odevincenti/Biosc/README.md

# Biosc

Desarrollo de un dispositivo de visualización y generación de señales con fines didácticos.
