odevincenti/Biosc/Diseño/Etapa de Entrada/Bioscope-Input-01/Bioscope-Input-01-SCH.pdf

# Bioscope Input Stage

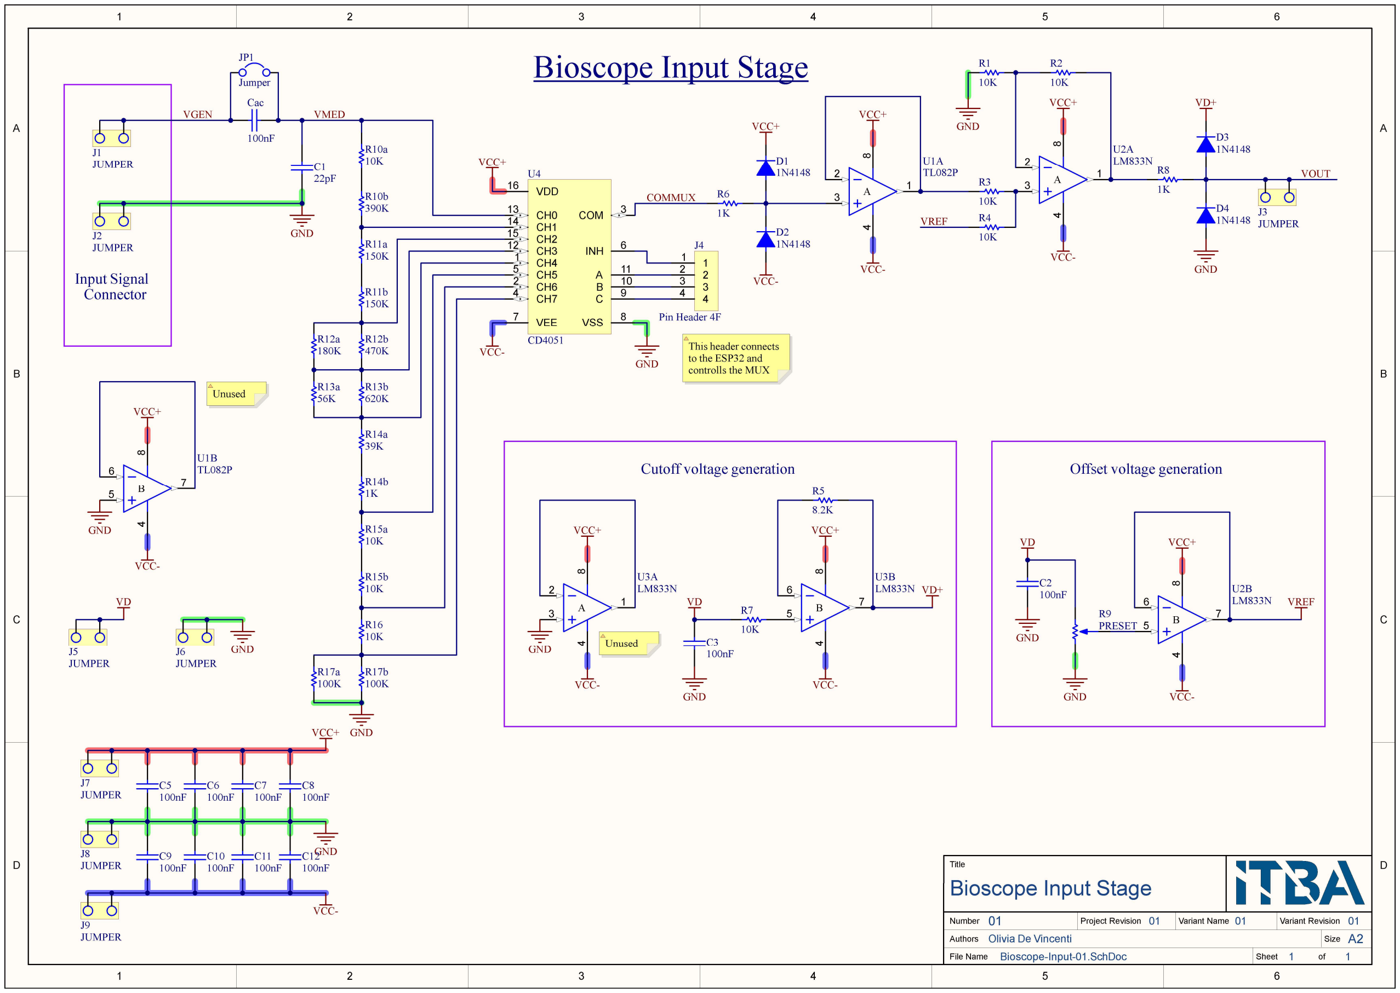
[picture p1: page 1]

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
# Bioscope Input Stage

A2
Bioscope-Input-01.SchDoc | 1

Title

Size

File Name | Sheet | of
Project Revision 01 | 01 | 01 Variant Revision
Olivia De Vincenti

Number 01

1

Authors

Variant Name

2

3

### 1 A⁸ 4

U2A
LM833N

5

6

### 7 B⁸ 4

U2B
LM833N

2

3

### 1 A⁸ 4

U3A
LM833N

5

6

### 7 B⁸ 4

U3B
LM833N

J1
JUMPER

J2
JUMPER

VGEN

Cac

100nF

JP1

Jumper

C1
22pF

GND

VMED

R10a
10K

R11a
150K

R12b
470K

R13b
620K

R14a
39K

R15a
10K

R16
10K

R17b
100K

GND

COMMUX

GND

INH 6

C

9

CH0 13
CH1 14
CH2 15
CH3 12
CH4 1
CH5 5
CH6 2
CH7 4

VDD 16

VEE 7 | VSS | 8
COM | 3

A

11
B

10

U4

CD4051

VCC+

VCC-

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
Pin Header 4F

D1
1N4148

D2
1N4148

VCC+

VCC-

2

3

### 1 A⁸ 4

U1A
TL082P

5

6

### 7 B⁸ 4

U1B
TL082P

VCC+

VCC-

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
VREF

VCC+

VCC-

VOUT

J7
JUMPER

J8
JUMPER

GND

J9
JUMPER

VCC+

VCC-

J3
JUMPER

VCC+

VCC-

VCC+

VCC-

VD+
VD

R5
8.2K

R7
10K

VCC+

VCC-

VREF

VD

GND

C2
100nF

C5
100nF

C6
100nF

C7
100nF

C9
100nF

C10
100nF

C11
100nF

C8
100nF

C12
100nF

GND C3
100nF

GND

VCC+

VCC-

GND

J5
JUMPER

VD

J6
JUMPER

GND

## Input Signal Connector

Cutoff voltage generation | Offset voltage generation

R10b
390K

R11b
150K

R12a
180K

R13a
56K

R14b
1K

R15b
10K

R17a
100K

R6
1K

D3
1N4148

D4
1N4148

VD+

R8
1K

GND

GND

R9
PRESET

This header connects
to the ESP32 and
controlls the MUX

Unused

Unused
