odevincenti/Biosc/Documentación/Componentes.md

# Componentes

- Microprocesador: [ESP-WROOM-32](https://www.espressif.com/sites/default/files/documentation/esp32-wroom-32_datasheet_en.pdf)
- Placa de desarrollo: [NODEMCU ESP-32S](https://docs.ai-thinker.com/_media/esp32/docs/nodemcu-32s_product_specification.pdf) V1.1 (38 pines)
- ADC: [ADS1115](https://www.ti.com/lit/ds/symlink/ads1115.pdf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) ADC 16 bits 860sps 2 canales
- Generador de señal: [AD9833](https://www.analog.com/media/en/technical-documentation/data-sheets/ad9833.pdf)
- Convertidor aislado: [B1212S-2WR2](https://www.micros.com.pl/mediaserver/info-dc%20a0505s-2wr2.pdf) Convertidor aislado 12V-12V no regulado para usar como fuente partida ±12V.
- Convertidor switching: [CN6009](https://www.pollin.de/productdownloads/D351434D.PDF) Regulador Step Up Vout 0V - 60V
- Fuente de alimentación: [PWR-5V2A](https://www.todomicro.com.ar/FUENTES-DE-ALIMENTACION/666-fuente-de-alimentacion-5v-2a.html) Fuente 5V 2A, entrada de la pared.
