odevincenti/Biosc/Diseño/Etapa de Entrada/Bioscope-Input-01/Bioscope-Input-01-BOM.xlsx

Comment | Description | Designator | Footprint | LibRef | Quantity
22pF |  | C1 | CAP100 | CAP | 1
100nF |  | C2, C5, C6, C7, C8, C9, C11, C12, Cac | CAP100 | CAP | 9
100nF |  | C3, C10 | CAP200 | CAP | 2
1N4148 |  | D1, D2, D3, D4 | DO41 | DIODO | 4
JUMPER |  | J1, J2, J3, J5, J6, J7, J8, J9 | JUMPER2 | JUMPER | 8
Pin Header 4F | Pin Header, Female, 4 positions | J4 | PINHEADER-4F | PINHEADER-4F | 1
Jumper | 2.54mm 2 pin header and jumper | JP1 | JUMPER-HEADER | Jumper Header | 1
10K |  | R1, R2, R3, R4, R7, R10a, R15a, R15b, R16 | RES400 | RES | 9
8.2K |  | R5 | RES400 | RES | 1
1K |  | R6, R8, R14b | RES400 | RES | 3
PRESET |  | R9 | PRESET V | PRESET | 1
390K |  | R10b | RES400 | RES | 1
150K |  | R11a, R11b | RES400 | RES | 2
180K |  | R12a | RES400 | RES | 1
470K |  | R12b | RES400 | RES | 1
56K |  | R13a | RES400 | RES | 1
620K |  | R13b | RES400 | RES | 1
39K |  | R14a | RES400 | RES | 1
100K |  | R17a, R17b | RES400 | RES | 2
TL082P | JFET-Input Operational Amplifier | U1 | P008 | TL082P | 1
LM833N | Low-Noise Dual Operational Amplifier | U2, U3 | DIP8 | LM833N | 2
CD4051 | Single 8-Channel Analog Multiplexer or Demultiplexer | U4 | SOIC16 | CD4051BF | 1
