odevincenti/Biosc/Documentación/Especificaciones de Diseño.xlsx

Sheet: Especificaciones de medición
Especificaciones de diseño - Etapa de medición
ID | Descripción | Origen
INT-MED-01 | El dispositivo deberá contar con un módulo ADC | REQ-01
INT-MED-02 | El dispositivo deberá contar con circuito de atenuación/amplificación para medir en el rango entre ±100mV y ±12V | REQ-02
INT-MED-03 | El dispositivo deberá poder ajustar el grado de atenuación/amplificación tal que la resolución de la señal sea óptima | REQ-02
INT-MED-04 | El módulo ADC deberá contar con una frecuencia de sampleo mayor a 200KHz | REQ-03
INT-MED-05 | El circuito de medición deberá tener un ancho de banda mayor a 100KHz | REQ-03
INT-MED-06 | El dispositivo deberá contar con 4 circuitos de medición | REQ-04
INT-MED-07 | La etapa de entrada del circuito de medición deberá contar con un limitador de tensión | REQ-05
INT-MED-08 | El circuito de medición deberá contar con una alta impedancia de entrada | REQ-05

Sheet: Especificaciones de generación
Especificaciones de diseño - Etapa de generación
ID | Descripción | Origen
INT-GEN-01 | El dispositivo deberá contar con una fuente partida de ±12V | REQ-12
INT-GEN-02 | El dispositivo deberá contar con un generador de señales senoidales, cuadradas y triangulares con frecuencias de hasta 1MHz | REQ-13
INT-GEN-03 | El dispositivo deberá contar con circuito de atenuación/amplificación para generar señales de hasta 10Vpp | REQ-13
INT-GEN-04 | El circuito de medición deberá tener un ancho de banda mayor a 100KHz | REQ-13
INT-GEN-05 | El circuito deberá contar con un regulador lineal para generar tensiones continuas de offset entre ±5V | REQ-14
INT-GEN-06 | El circuito deberá contar con una conexión interna al canal 4, que se habilite para medir la señal generada | REQ-15
INT-GEN-07 | El circuito de generación deberá contar con un fusible y un varistor en la salida | REQ-05

Sheet: Especificaciones de display
Especificaciones de diseño - Interfaz Gráfica de Usuario
ID | Descripción | Origen
INT-DISP-01 | La interfaz gráfica de usuario (GUI) deberá ser una aplicación que corra desde una computadora | REQ-01
INT-DISP-02 | La aplicación deberá ser portable entre sistemas operativos, pudiendo ser compilada en Windows, Mac y Linux | REQ-01
INT-DISP-03 | La GUI deberá poder representar las señales en tiempo real | REQ-01
INT-DISP-04 | La GUI deberá poder superponer las señales de los 4 canales | REQ-04
INT-DISP-05 | La GUI deberá permitir seleccionar qué canales representar | REQ-08
INT-DISP-06 | La GUI deberá contar con un botón Run/Stop para habilitar la representación gráfica de las señales | REQ-06
INT-DISP-07 | La GUI deberá permitir ajustar la escala horizontal de todos los canales representados en una base de tiempo compuesta por décadas múltiples de 1, 2, y 5 | REQ-07
INT-DISP-08 | La GUI deberá permitir ajustar el offset horizontal de todos los canales representados en un valor arbitrario | REQ-07
INT-DISP-09 | La GUI deberá permitir ajustar la escala vertical de cada canal representado por separado, en una base de tiempo compuesta por décadas múltiples de 1, 2, y 5 | REQ-07
INT-DISP-10 | La GUI deberá permitir ajustar el offset vertical de cada canal representadas en un valor arbitrario | REQ-07
INT-DISP-11 | La GUI deberá permitir ajustar la escala vertical de cada canal con la ruedita del mouse, para una mejor experiencia de usuario | REQ-01
INT-DISP-12 | La GUI deberá contar con un sistema de Trigger, que permita configurar el tipo (ascendente, descendente, ambos), el canal de referencia y el nivel de Trigger | REQ-09
INT-DISP-13 | La GUI deberá contar con un botón que setee el modo Single | REQ-10
INT-DISP-14 | La GUI deberá permitir seleccionar entre los modos Roll, Trigger y XY para la representación de las señales | REQ-10
INT-DISP-15 | La GUI deberá permitir exportar una imagen en formato PNG que muestre las señales representadas junto con la escala de cada canal y la base de tiempo | REQ-11
INT-DISP-16 | La GUI deberá permitir exportar los puntos de las señales representadas en formato CSV, con una estructura similar a la de un osciloscopio convencional | REQ-11
INT-DISP-17 | La GUI deberá contar con un botón que habilite la medición de la señal generada en el canal 4 | REQ-15
INT-DISP-18 | La GUI deberá poder funcionar correctamente sin conexión a internet | REQ-18

Sheet: Especificaciones de interfaz
Especificaciones de diseño - Interfaz de datos
ID | Descripción | Origen
INT-COM-01 | La transmisión de datos debe realizarse mediante un cable Micro-USB a USB-A. | REQ-01
INT-COM-02 | La comunicación entre la GUI y el dispositivo deberá ser a través del protocolo UART, con un baud rate de 460800 bits/s | REQ-01
INT-COM-03 | La comunicación entre la GUI y el dispositivo deberá ser codificada con un protocolo de comunicación para reducir el tamaño de la transmisión | REQ-01
INT-COM-04 | La transmisión de los datos de las señales se realizará desde el dispositivo hacia la GUI | REQ-01
INT-COM-05 | El dispositivo deberá transmitir información de los canales seleccionados en paquetes de datos, cada intervalos periódicos | REQ-01
INT-COM-06 | La transmisión de comandos se realizará desde la GUI hacia el dispositivo | REQ-01
INT-COM-07 | Ante un error de lectura se deberá enviar un mensaje de error indicando el tipo de mensaje y el tipo de error | REQ-01
