odevincenti/Biosc/Documentación/Requerimientos de Cliente.xlsx

Requerimientos de Cliente
ID | Descripción | Origen
REQ-01 | El dispositivo deberá poder medir señales eléctricas y representarlas en una interfaz gráfica de usuario (GUI) de computadora intuitiva | Cliente
REQ-02 | El dispositivo deberá poder medir señales con amplitud entre ±100mV y ±12V | Cliente
REQ-03 | El dispositivo deberá poder medir señales con frecuencias hasta 100KHz | Cliente
REQ-04 | El dispositivo deberá poder medir hasta 4 señales al mismo tiempo | Cliente
REQ-05 | El dispositivo deberá estar protegido contra sobretensiones y sobrecorrientes | Tácito
REQ-06 | La GUI deberá permitir detener y reanudar la representación de la señal medida | Tácito
REQ-07 | La GUI deberá permitir ajustar la escala y offset tanto vertical como horizontal de la representación de la señal medida | Cliente
REQ-08 | La GUI deberá permitir seleccionar los canales a representar | Tácito
REQ-09 | La GUI deberá contar con un sistema de Trigger | Cliente
REQ-10 | La GUI deberá poder replicar los modos Single, Roll, Trigger y XY de un osciloscopio convencional | Cliente
REQ-11 | Se deberán poder extraer los datos en pantalla en formato PNG y CSV | Cliente
REQ-12 | El dispositivo deberá poder generar una tensión continua de ±12V | Cliente
REQ-13 | El dispositivo deberá poder generar señales alternas del tipo senoidal, cuadrada y triangular con amplitud hasta 10Vpp y frecuencia hasta 1MHz | Tácito
REQ-14 | El dispositivo deberá poder aplicarle offsets de hasta ±5V a las señales generadas | Cliente
REQ-15 | El dispositivo deberá permitir medir la señal generada | Tácito
REQ-16 | El dispositivo deberá permitir al usuario configurar la señal generada con botones y selectores físicos | Tácito
REQ-17 | El dispositivo deberá poder reportar su estado mediante luces indicadoras | Cliente
REQ-18 | El tamaño del dispositivo deberá ser portátil, estar aislado y no requerirá conexión a internet | Cliente
REQ-19 | El dispositivo requerirá conexión a la red eléctrica para su funcionamiento. | Tácito
REQ-20 | El dispositivo deberá funcionar correctamente a temperatura ambiente | Tácito
