odevincenti/Biosc/Diseño/Etapa de Entrada/Bioscope-Input-01/Bioscope-Input-01-PCB.pdf

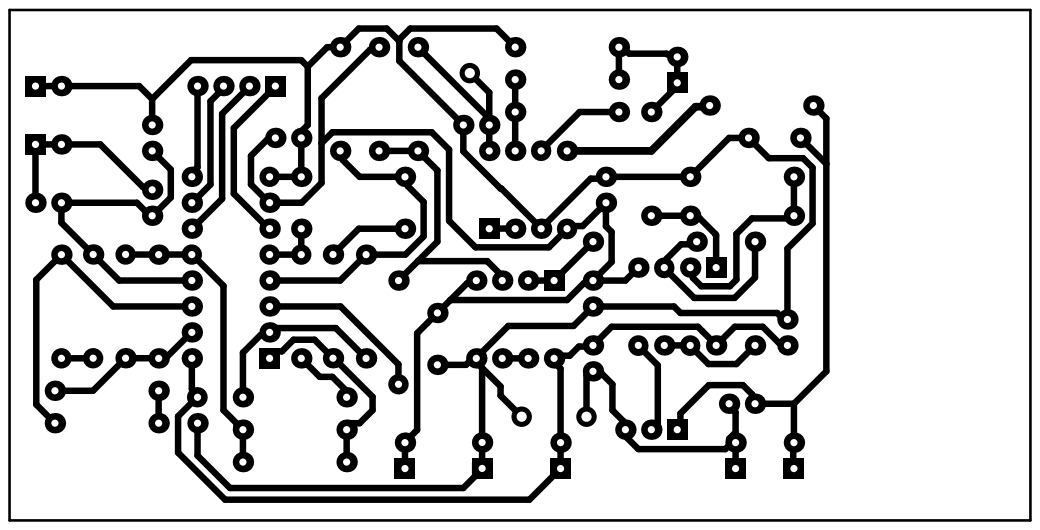
[picture p5: page 1]

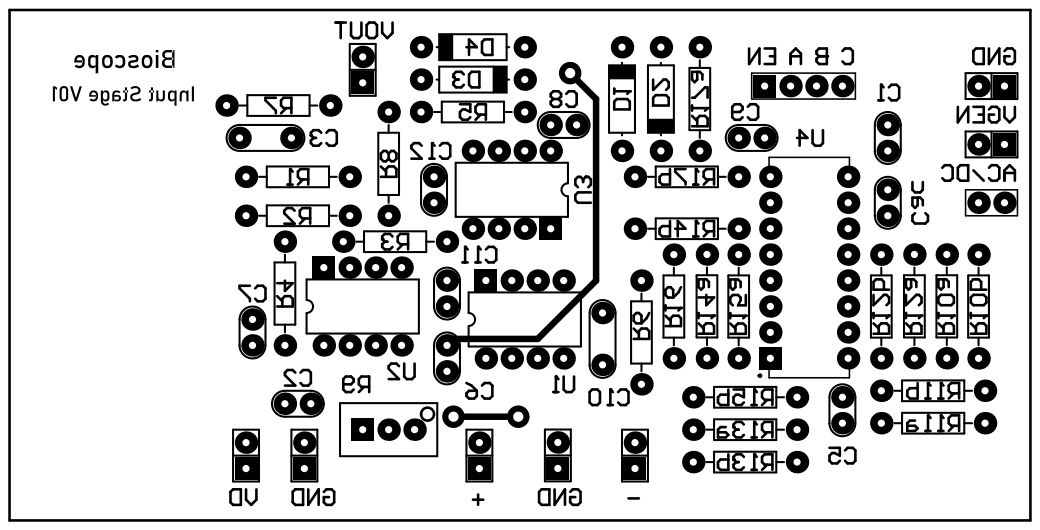
[picture p6: page 2]
