odevincenti/Biosc/Diseño/Etapa de Entrada/Bioscope-Input-01/Bioscope-Input-01-PCBREF.pdf

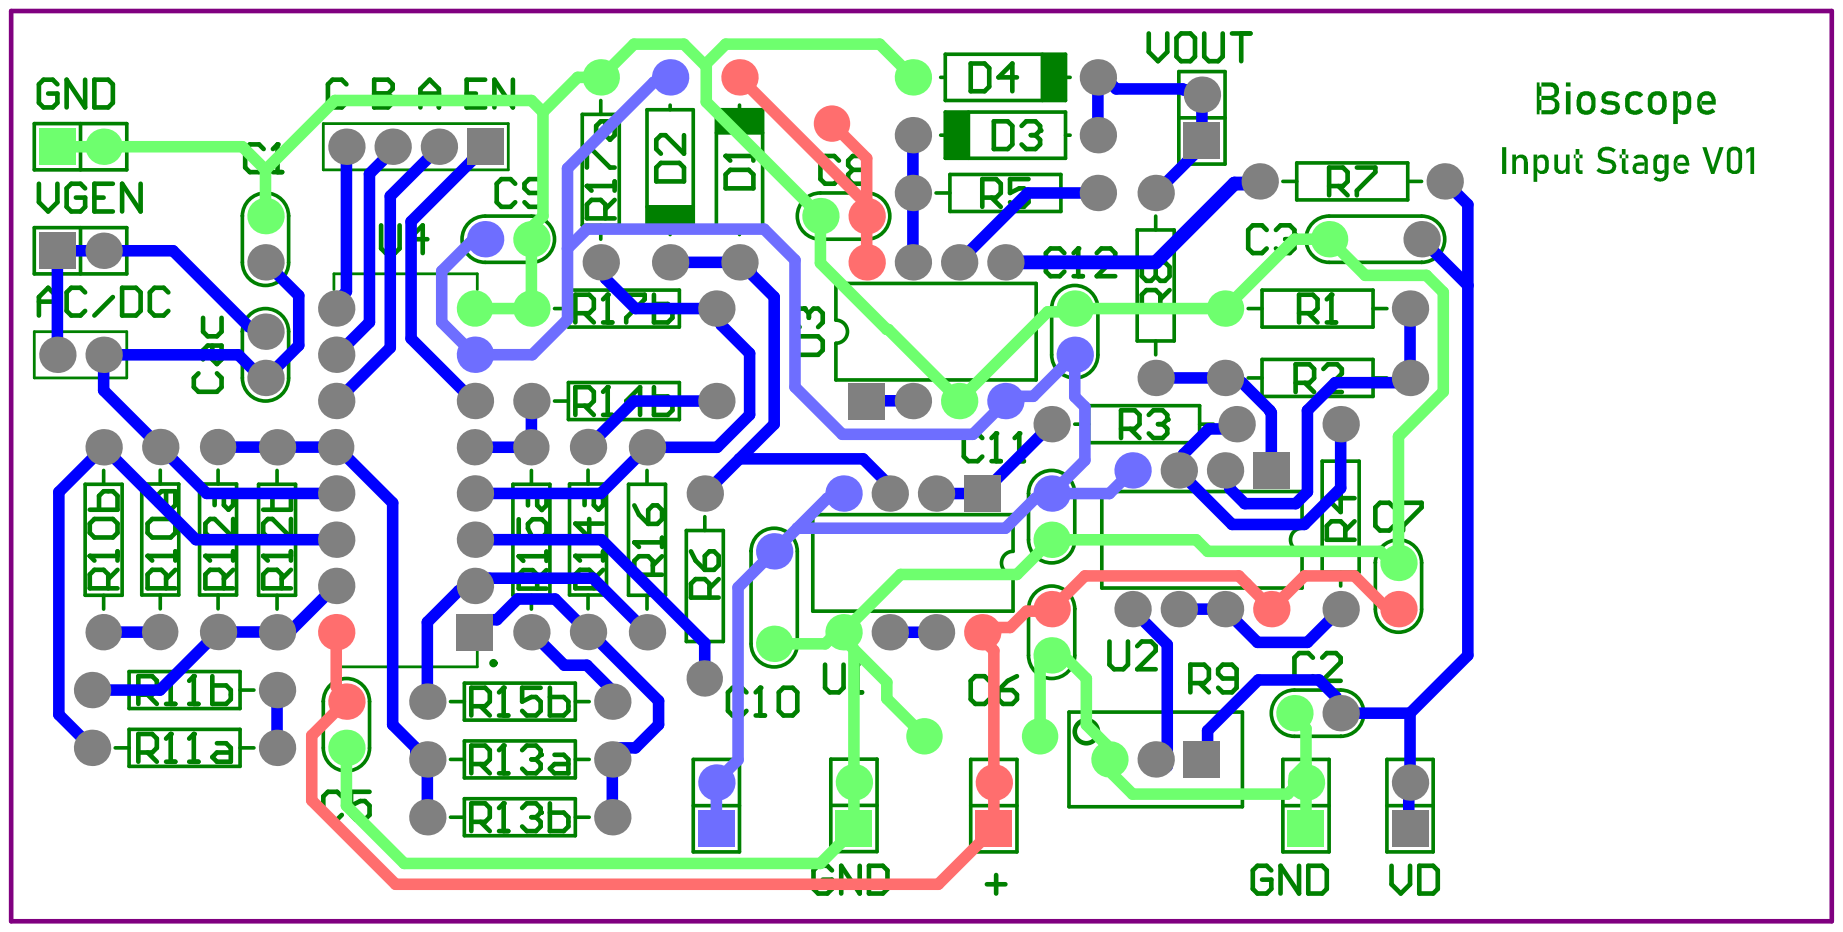
[picture p7: page 1]

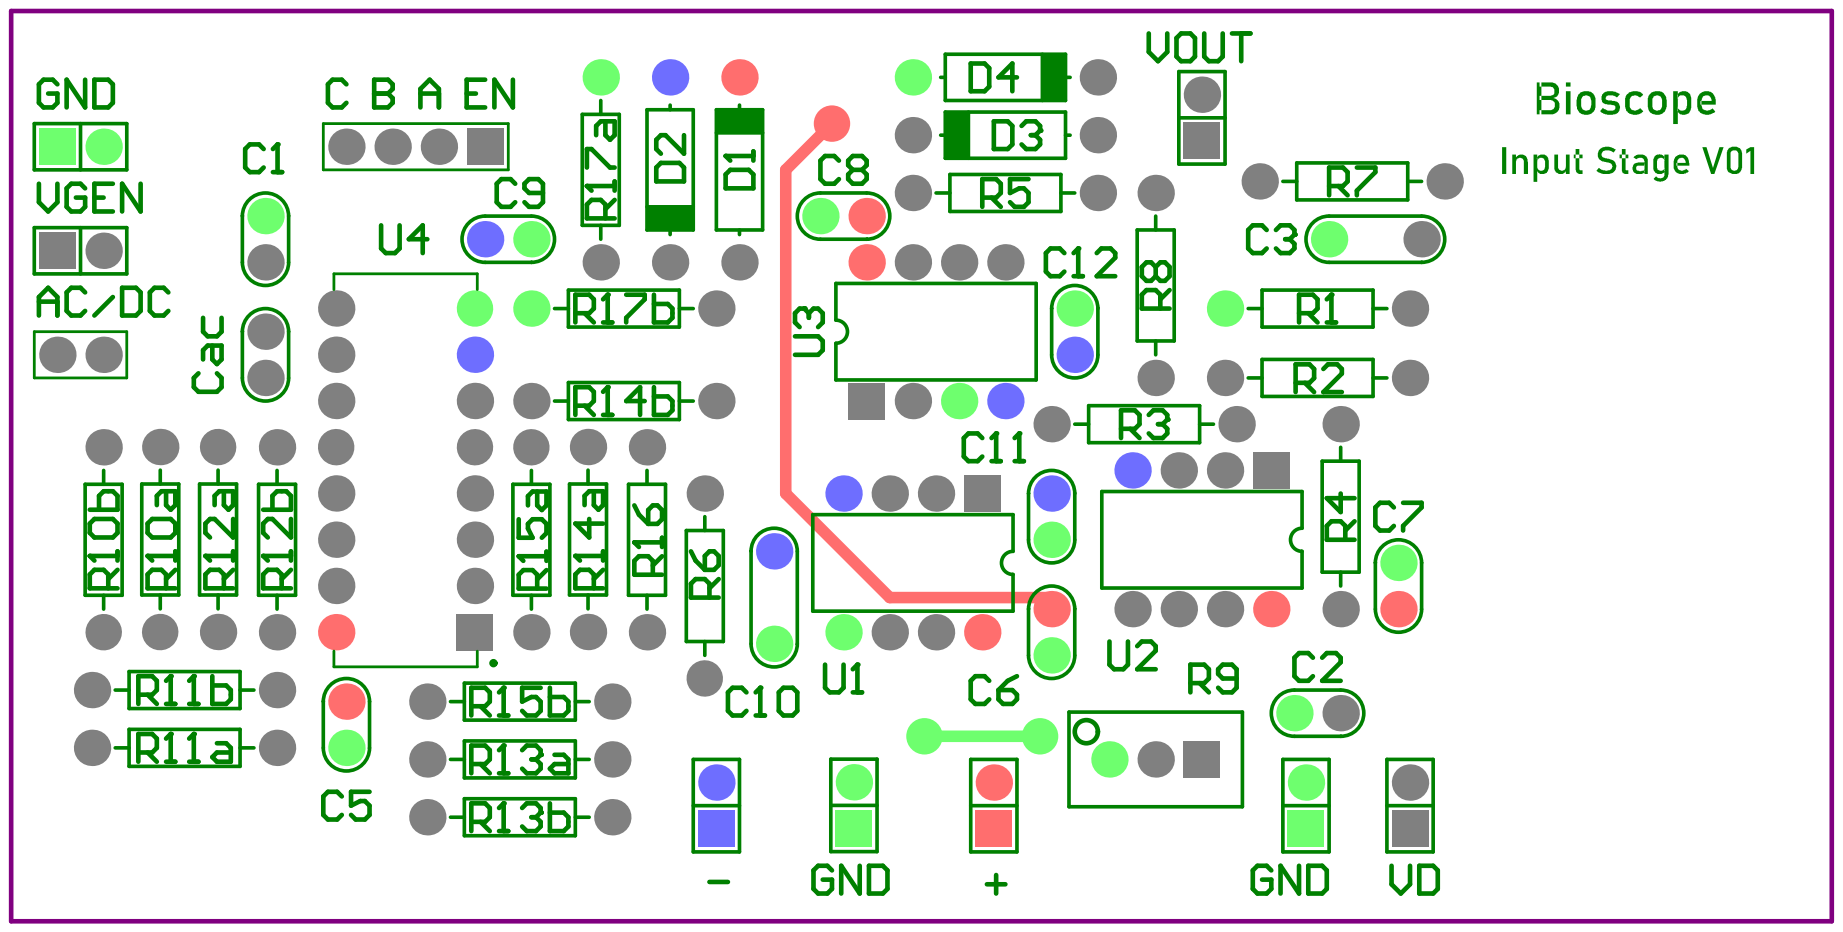
[picture p8: page 2]
