odevincenti/Biosc/Diseño/Etapa de Entrada/Etapa de Entrada v4.asc

C1: cap; 22p
Cac: cap; 100n
D1: diode; 1N4148
D2: diode; 1N4148
R1: res; 1k
R2: res; 1k
R3: res; 10k
R4: res; 10k
R5: res; 10k
R6: res; 10k
R7: res; 10k
R8: res; 10k
R10: res; 10k
R11: res; 365k
R12: res; 225k
R13: res; 150k
R14: res; 93k
R15: res; 57k
R16: res; 38k
R17: res; 112k
Radc: res; 37k
U1: TL081
U2: LM833
U3: LM833
U4: LM833
U5: LM833
V1: battery; 12
V2: battery; -12
V3: voltage; 3.3
Vi: voltage; PULSE(-12 12 0 1n 1n 5u 10u); AC 1
X1: jumper
Named nets: Vin, 0, Vout, Vcc+, Vcc-, -Vd, Vref, CH0, CH1, CH2, CH3, CH4, CH5, CH6, CH7, Vm, COMMUX, Vd, +Vd
.tran 0 1m 0.9m
.ac dec 1000 1 1Mega
Clamp
AC/DC
Input
Atenuación + Nivel de Continua
Generación de Vref
Fuente partida
Señal de prueba
Simulación
Generación de +-Vd
