odevincenti/Biosc/Diseño/Etapa de Entrada/Etapa de Entrada.asc

C1: cap; 10p
Cac: cap; 100n
D1: diode; 1N4148
D2: diode; 1N4148
R1: res; 820k
R2: res; 180k
R3: res; 1Mega
R4: res; 1Mega
R5: res; 5k
R6: res; 1k
R7: res; 1k
R8: res; 20k
R9: res; 10k
Radc: res; 37k
U1: LM833
U2: LM833
U3: TL081
V1: battery; 12
V2: battery; -12
V3: voltage; 3.3
Vi: voltage; SINE(0 12 5k); AC 1
X1: jumper
Named nets: Vin, 0, Vout, Vcc+, Vcc-, Vref
.tran 0 10m 0
.ac dec 1000 1 1Mega
Clamp
AC/DC
Input
Atenuación + Nivel de Continua
Generación de Vref
Fuente partida
Señal de prueba
Simulación
