odevincenti/Biosc/Diseño/Etapa de Generación/Etapa de Generacion v1.asc

R1: res; 10k
R2: res; 16k
R3: res; 1k
R4: res; 1k
R5: res; 500
R6: res; 1k
R7: res; 1k
R8: res; 100k
R11: res; 100k
Radc: res; 37k
U1: LM7809
U2: LM833
U3: LM833
U4: LM833
V1: battery; 12
V2: battery; -12
V3: voltage; 12
Vi: voltage; SINE(0 1 100k); AC 1
Named nets: Vg, 0, Vout, Vcc+, Vcc-, Vdc
.tran 0 10m 0
.ac dec 1000 1 1Mega
Amplificación
Generación de Vdc
Fuente partida
Generador de señal
Simulación
