odevincenti/Biosc/(list of files, drawings)

Other design files:
Diseño/Etapa de Entrada/Bioscope-Input-01/Bioscope-Input-01.PrjPcb
Diseño/Etapa de Entrada/Bioscope-Input-01/PCB/Bioscope-Input-01.PcbDoc
Diseño/Etapa de Entrada/Bioscope-Input-01/SCH/Bioscope-Input-01.SchDoc
