odevincenti/Biosc/Testing/ESP32 Tests/Protocolo/src/main.cpp

#include "Arduino.h"
#include "serial_handler.h"
#include "utils.h"

// #define LED_BUILTIN 2
// #define DEBUG
#define SIGNAL_LEN  100
#define CHANNEL_N  2

char receivedChars[MAX_CHARS];
boolean newData = false;
bool blink = false;
bool running = false;
int ch1_signal[SIGNAL_LEN];  
int ch2_signal[SIGNAL_LEN];
enum channels {CH1 = 1, CH2, CH3, CH4};
bool channel_en[CHANNEL_N] = {1, 1};
typedef struct ch_range {
    double min;
    double max;
} ch_range;
ch_range channel_range[CHANNEL_N] = {{.min=-0.6, .max=0.6}, {.min=-0.3, .max=0.3}};

using namespace std;


void setup()
{
  pinMode(LED_BUILTIN, OUTPUT);
  	Serial.begin(BAUD_RATE);    // open serial port
    int i;
    for(i = 0; i < SIGNAL_LEN; i++){    // generate sine wave signal
        ch1_signal[i] = 100 * sin(2 * M_PI * i / SIGNAL_LEN) + 100;
        ch2_signal[i] = 100 * cos(2 * M_PI * i / SIGNAL_LEN) + 100;
    }
}


void send_signal(){
    String msg = "{\"command\":\"MS\",\"data\":[";
    int ch;
    for (ch = 0; ch < CHANNEL_N; ch++){
        if (channel_en[ch]){
            if (ch != 0){
                msg = msg + ",";
            }
            msg = msg + "{\"channel\":" + String(ch+1) + ",";
            msg = msg + "\"range\":[" + String(channel_range[ch].min) + "," + String(channel_range[ch].max) + "],";
            msg = msg + "\"signal\":[" + array2String(ch1_signal, SIGNAL_LEN) + "]";
            msg = msg + "}";
        }
    }
    msg = msg + "]}\n";
    Serial.print(msg);
}

void loop(){
    newData = recvWithStartEndMarkers(&receivedChars[0], &newData);
    if (newData || blink || running){ 
#ifdef DEBUG
		Serial.println(receivedChars);
#endif
        if (receivedChars[0] == 'H'){
            running = false;
            blink = false;
            digitalWrite(LED_BUILTIN, HIGH);
        } else if (receivedChars[0] == 'L'){
            running = false;
            blink = false;
            digitalWrite(LED_BUILTIN, LOW);
        } else if (blink || receivedChars[0] == 'B'){
            running = false;
            blink = true;
            digitalWrite(LED_BUILTIN, HIGH);
            delay(500);
            digitalWrite(LED_BUILTIN, LOW);
            delay(500);
        } else if (receivedChars[0] == 'M' && receivedChars[1] == 'S'){
            running = false;
            blink = false;
            send_signal();
        } else if (receivedChars[0] == 'T'){
            running = false;
            Serial.print("Test");
        } else if (receivedChars[0] == 'R'){
            running = true;
            send_signal();
        } else if (receivedChars[0] == 'S'){
            running = false;
            Serial.print("Stop");
        } newData = false;

    }
}
