odevincenti/Biosc/Testing/ESP32 Tests/Protocolo+ADC/include/serial.h

// // serial.h

// #ifndef SERIAL_H  // Directiva del preprocesador para evitar inclusiones múltiples
// #define SERIAL_H

// #include "HardwareSerial.h"

// class UART_Driver : public HardwareSerial {

// private:

// 	const int TX;
//     const int RX;

// public:

//     UART_Driver(int uart_n, int tx_pin, int rx_pin);
// };

// #endif  // SERIAL_H
