odevincenti/Biosc/(commit log)

2024-04-29 Agrego pruebas ESP32
2024-04-29 Lista de componentes
2024-04-29 Diagrama de bloques eléctrico. Etapas de entrada y generación
2024-05-06 Agrego Tests para la fuente aislada B1212S
2024-05-24 Add serial commands to ESP32 test
2024-08-06 primeros tests de gui con ESP
2024-08-08 Agrego datasheets ESP32
2024-08-09 Agrego todo lo referente al test del generador de señal AD9833
2024-08-14 updated serial write test to properly use timer
2024-08-21 Agrego diseño de etapa de entrada de medición
2024-08-21 Agrego Requerimientos de Cliente
    [Requerimientos de Cliente.xlsx]
2024-08-21 Agrego Especificaciones de Diseño
    [Especificaciones de Diseño.xlsx]
2024-08-28 ADC Test
2024-08-28 Agrego etapa de generación
2024-08-28 Actualizo etapa de entrada
2024-09-13 Actualizo requerimientos
    [Especificaciones de Diseño.xlsx, Requerimientos de Cliente.xlsx]
2024-09-13 Subo código de test de protocolo
2024-10-16 Actualizo documentación
    [Especificaciones de Diseño.xlsx]
2024-10-30 threading test
2024-10-30 time and voltage scales
2024-12-02 Agrego código Protocolo+ADC que transmite la señal muestreada (sample rate hasta 10k)
2024-12-02 Actualizo para que envíe datos constantemente (sample rate hasta 5k)
2024-12-04 trying qt based threadin
2024-12-18 PCB Etapa de Entrada
    [Bioscope-Input-01.PcbDoc, Bioscope-Input-01.PrjPcb, Bioscope-Input-01.SchDoc]
2024-12-20 Cambios en PCB de Etapa de Entrada
    [Bioscope-Input-01-BOM.xlsx, Bioscope-Input-01.PcbDoc, Bioscope-Input-01.PrjPcb, Bioscope-Input-01.SchDoc]
2025-01-06 generalized channel frame
2025-02-14 added framerate support
